con-f-use/PERSwitch/docu/controller-frontside.jpg

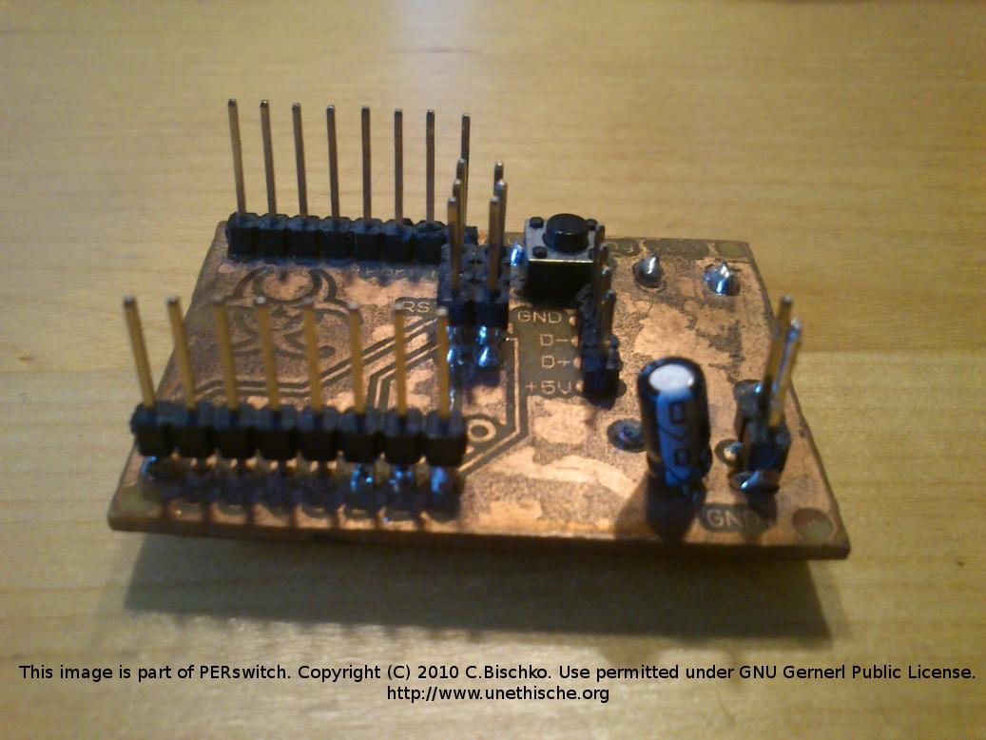
docu/controller-frontside.jpg
