con-f-use/PERSwitch/README.md

The files that came with this readme are part of the PERSwtich USB power swtich
project. It is a simple free electronics project based on an AtTiny26
(or similar) microcontroller.

For more details see the Documentation in the ./docu directory of this program.
