con-f-use/PERSwitch/boards/controller-eagle.png

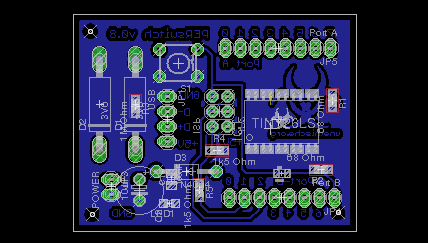
boards/controller-eagle.png
