con-f-use/PERSwitch/boards/controller-schematic.png

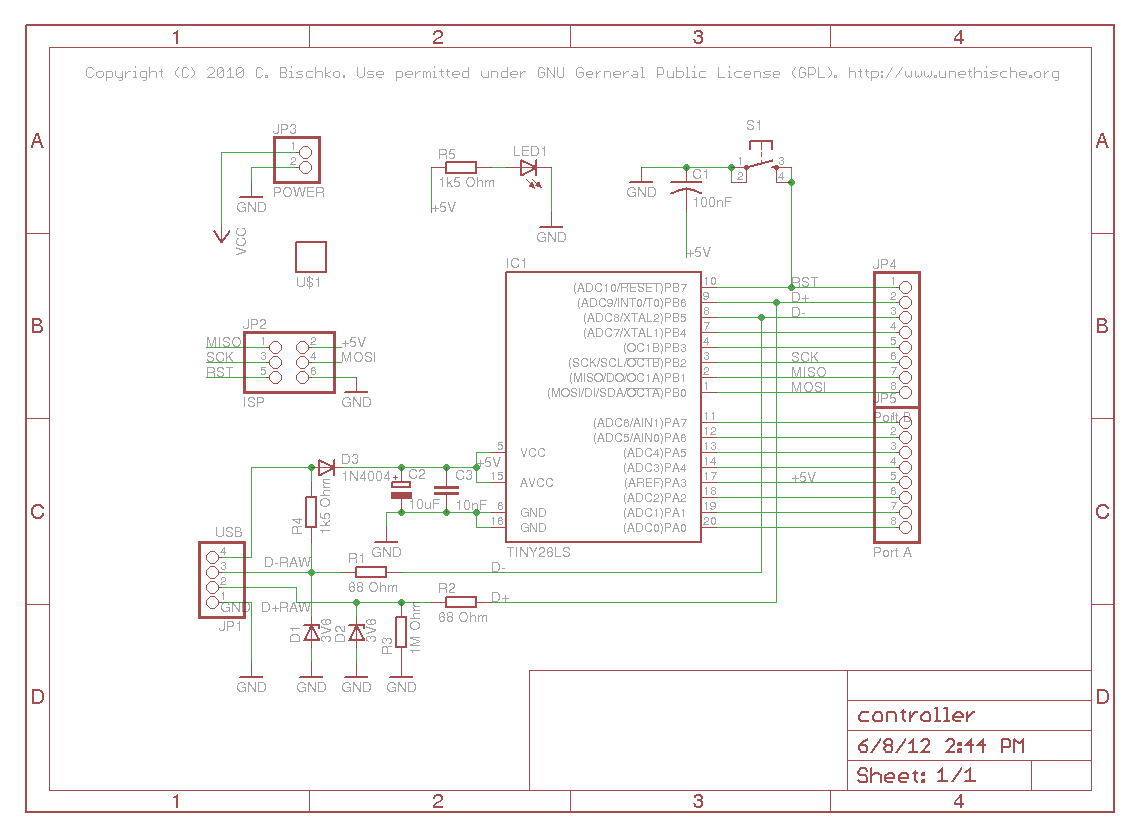
boards/controller-schematic.png
