con-f-use/PERSwitch/boards/relay-eagle.png

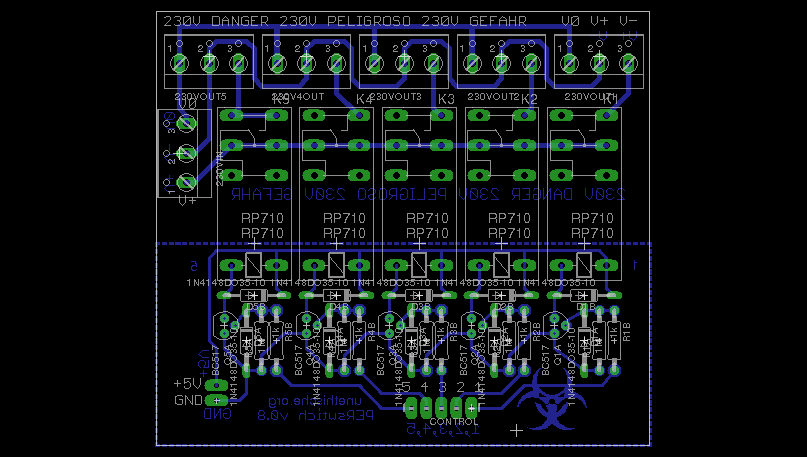
boards/relay-eagle.png
