con-f-use/PERSwitch/boards/relay-schematic.png

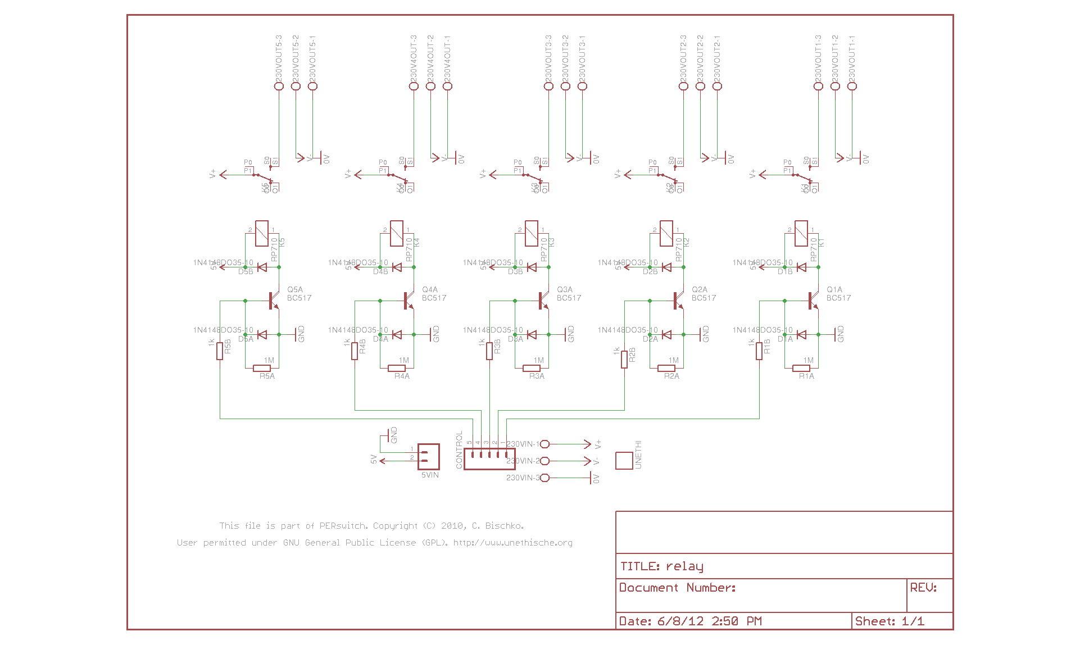
boards/relay-schematic.png
