con-f-use/PERSwitch/boards/controller-schematic 1.pdf

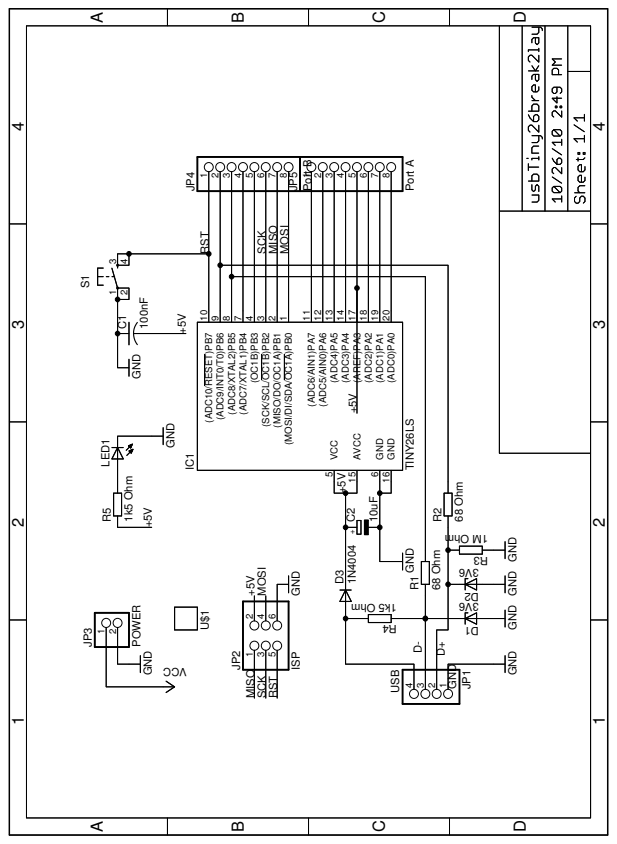
[picture p8: page 1]
