con-f-use/PERSwitch/boards/relay-schematic 1.pdf

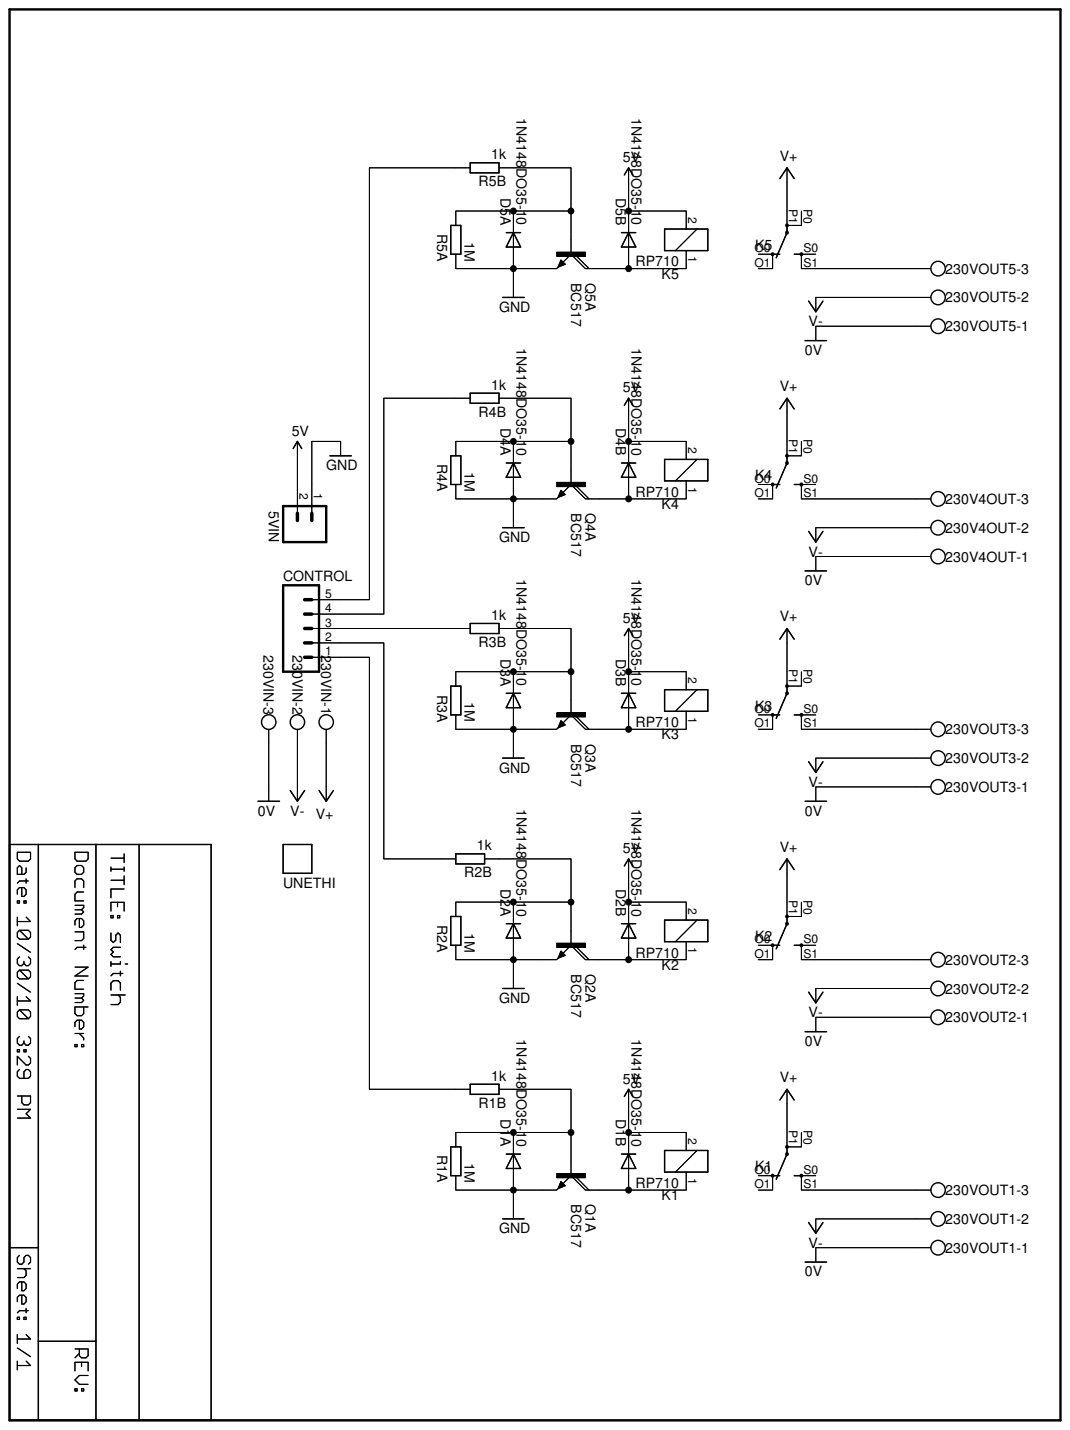
[picture p9: page 1]
