con-f-use/PERSwitch/boards/controller-brd 1.pdf

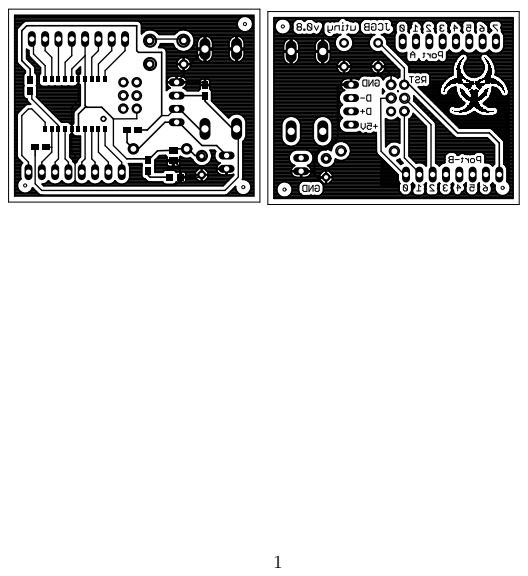
[picture p10: page 1]
