con-f-use/PERSwitch/boards/relay-brd 1.pdf

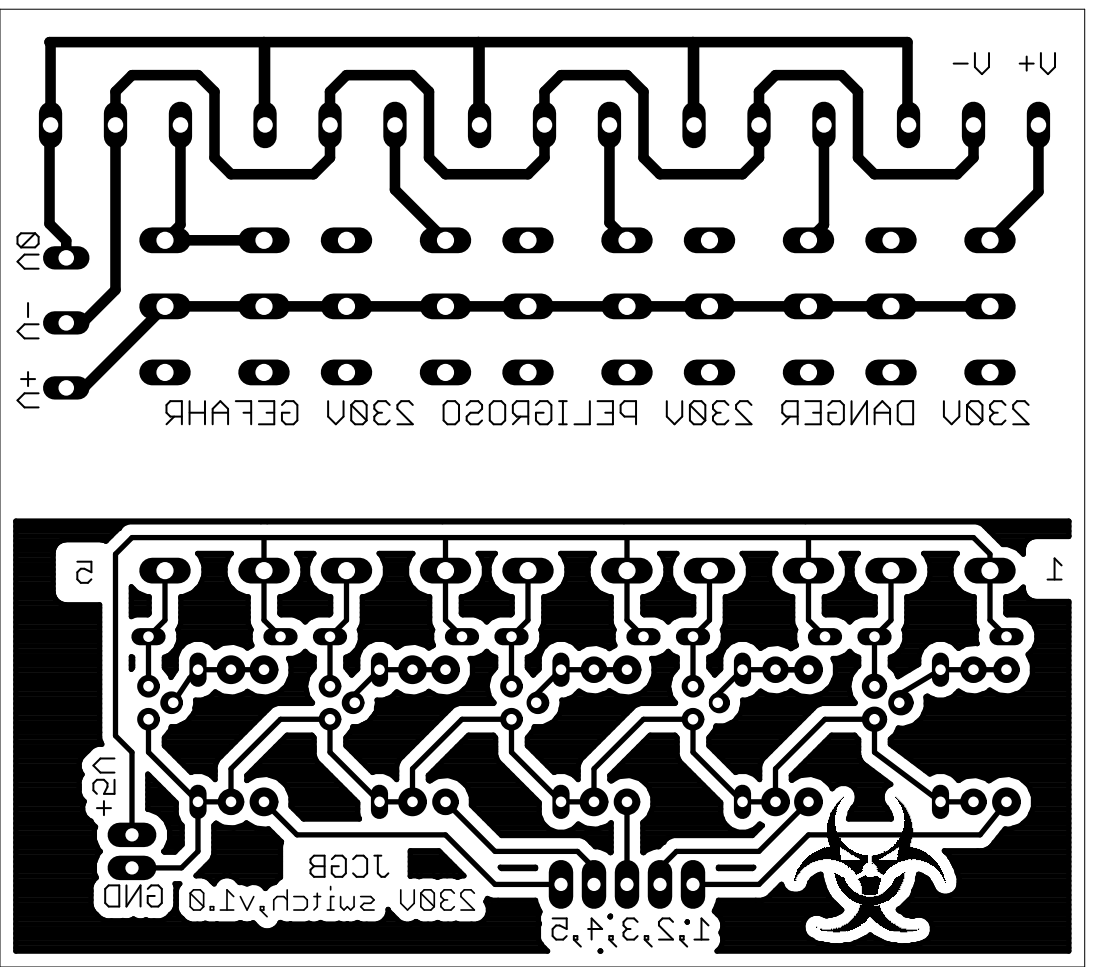
[picture p11: page 1]
