con-f-use/PERSwitch/boards/eagle/controller.brd

## EAGLE design boards/eagle/controller.brd (2015-07-22)

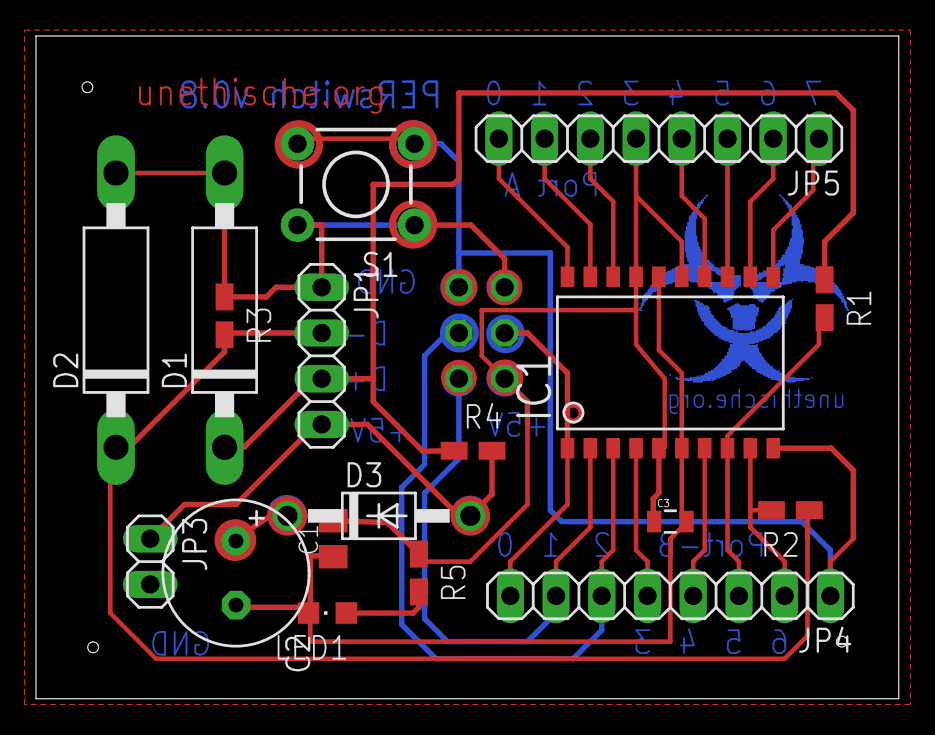
[picture p12: board controller.brd from above]

Board: 2 copper layers, 47.9 x 36.8 mm, 20 parts (1 on the bottom side), 21 nets.

Parts:
C1: 100nF; C0805K
C2: 10uF; E3,5-8
C3: 10nF; 0805
D1, D2: 3V6; C1702-15
D3: 1N4004; DO41-10
IC1: TINY26LS; SO20L
JP1: USB; 1X04
JP2: ISP; 2X03
JP3: POWER; 1X02
JP4: Port B; 1X08
JP5: Port A; 1X08
LED1: CHIPLED_0805
R1, R2: 68 Ohm; R0805W
R3: 1M Ohm; R0805W
R4, R5: 1k5 Ohm; R0805W
S1: TACTILE-PTH
U$1: UNETHILOGO

Connections:
+5V: C1.2, C2.+, C3.1, D3.C, IC1.5, IC1.15, IC1.17, JP2.2, JP5.5, R5.1
D+: IC1.9, JP4.2, R2.2
D+RAW: D2.C, JP1.2, R2.1, R3.2
D-: IC1.8, JP4.3, R1.2
D-RAW: D1.C, JP1.3, R1.1, R4.1
GND: C1.1, C2.-, C3.2, D1.A, D2.A, IC1.6, IC1.16, JP1.1, JP2.6, JP3.2, LED1.C, R3.1, S1.1, S1.2
MISO: IC1.2, JP2.1, JP4.7
MOSI: IC1.1, JP2.4, JP4.8
unnamed: LED1.A, R5.2
unnamed: IC1.7, JP4.4
unnamed: IC1.4, JP4.5
unnamed: IC1.20, JP5.8
unnamed: IC1.11, JP5.1
unnamed: IC1.12, JP5.2
unnamed: IC1.13, JP5.3
unnamed: IC1.14, JP5.4
unnamed: IC1.18, JP5.6
unnamed: IC1.19, JP5.7
RST: IC1.10, JP2.5, JP4.1, S1.3, S1.4
SCK: IC1.3, JP2.3, JP4.6
VCC: D3.A, JP1.4, JP3.1, R4.2
