con-f-use/PERSwitch/(commit log)

2015-07-22 Initial commit v0.8
    [PERgui.cfg, controller.brd, controller.sch, doxygen.cfg, relay.brd, relay.sch]
2017-07-31 USB warnings & generous matching vendor/device
    ToDo: Make this a compile time option (e.g. -DDEBUG).
